Harrishao/--------/工作日志.md

# 0606

- 确定运动方案
- 确定构件尺寸

# 0607

- 完成下冲头机构建模与独立组装，凸轮配合驱动正常，往复行程 24mm 验证通过
- 完成上冲头凸轮、摆杆、滚子建模（连杆、滑块/冲头待建）
- 细化下冲头顶出/复位与粉筛推卸相位，使各凸轮工作行程压力角 ≤30°；同步更新运动方案文档与运动循环图，三处数据一致
- 导出三套凸轮廓线 CSV（供 SolidWorks 曲线导入）
- 整理工程文件：按 设计文档 / 图表 / 三维模型 / 凸轮廓线 分类归档

# 0607b

- 优化了下冲头对滚子的开槽

# 0608

- 发现凸轮和摆杆存在干涉
  - 已解决，采用z轴避让方案

# 0609

- 完成主要部件的建模
- 重新校核了一些数据

# 0610-0612

- 彻底重建整机，现在是新的设计
