Harrishao/--------/待办事项.md

# 下一步做什么？

## 三维建模与组装
- [x] 下冲头机构
- [x] 上冲头机构
- [x] 粉筛机构
- [x] 整机装配：三凸轮按相位差装上同一主轴，加传动件（带轮/齿轮/飞轮），检查干涉
- [x] 多执行机构协调运动仿真，录制动画视频

## 运动分析
- [x] 选定分析对象（上冲头机构）
- [x] 建立位移/速度/加速度解析模型，出曲线（Matlab）

## 强度与尺寸校核
- [ ] 凸轮接触强度、齿轮齿面接触与齿根弯曲
- [ ] 杆件/销/轴强度，定下目前“建模辅助”截面
- [ ] 飞轮转动惯量按盈亏功定值

## 图纸与说明书
- [ ] 2 号图纸机构运动简图（最终方案，标注尺寸与运动副）
- [ ] CAD 零件工程图
- [ ] 编写设计计算说明书

## 打包成品

- [ ] 打包成品
