Harrishao/--------/强度与尺寸校核/关键部件强度校核.docx

关键部件 初次强度与尺寸校核

15吨压片机 · 解析法（材料力学/手册公式）

# 一、校核说明与假设

本节对整机关键承力部件作初次（设计阶段）强度与尺寸校核，方法为材料力学/设计手册解析公式，不需 ADAMS/ANSYS。所用载荷与数据取自前文：压片力 Fp=150 kN、主轴扭矩 T=746.5 N·m、各传动/机构尺寸、上冲头保压位坐标。

基本假设：①静力分析，忽略摩擦与构件自重、惯性力（初次校核）；②连杆按二力杆、力沿杆轴；③材料 45 钢调质，σs≈355 MPa、σb≈600 MPa；④许用值取 [σ]=235 MPa（n=1.5）、销 [τ]=90 MPa、[σ挤]=353 MPa、轴扭转 [τT]=40 MPa、齿轮 [σH]=550 / [σF]=250 MPa、凸轮接触 [σH]=1200 MPa（表面硬化）。

# 二、上冲头保压力链 静力分析

保压时上、下冲头对压 150 kN，上冲头反力经 小连杆→上摆杆→长连杆→下摆杆→滚子→凸轮 传递。取保压位各铰点坐标，按二力杆与杠杆取矩逐级求解，得：

传力件 | 轴力/接触力 | 方向 | 说明
小连杆 (C–E) | 150.9 kN | ≈竖直 | 直接承冲头反力
长连杆 (B–D) | 279.3 kN | 沿杆轴 | 经上摆杆 R3′/R3 放大
凸轮接触力 (滚子) | ≈492 kN | 接触法向 | 经下摆杆 LB/Lr 再放大

可见二级摆杆虽缩小了凸轮、减小了摆角，但力沿传动链逐级放大，凸轮接触力远高于压片力——这是后面凸轮接触校核的关键。

# 三、各部件强度校核

部件 | 载荷 | 现尺寸 | 计算应力 | 许用 | 结论 / 建议
冲头 φ34（压缩） | 150 kN | φ34 | 165 MPa | 235 | 合格 (n=2.15)
齿轮低速级 弯曲 | Ft=8294 N | m3,b50 | σF=146 | 250 | 合格
齿轮低速级 接触 | 同上 | — | σH=388 | 550 | 合格
主轴 扭转 | 746.5 N·m | φ20 | τ=475 MPa | 40 | 不合格 → 需 ≥φ46
C 销（小连杆-冲头） | 151 kN | φ8 | τ=1501 MPa | 90 | 不合格 → 需 ≥φ33
D / B 销（长连杆） | 279 kN | φ8 | τ=2778 MPa | 90 | 不合格 → 需 ≥φ44
小连杆（拉压） | 151 kN | 30×20 | σ=252 MPa | 235 | 不合格 → A≥642 mm²
长连杆（拉压） | 279 kN | 30×20 | σ=466 MPa | 235 | 不合格 → A≥1189 mm²
长连杆（压杆稳定） | 279 kN | 30×20,L424 | Pcr=509 kN | ≥2F | 裕度不足(Pcr/F=1.8)
上冲头凸轮 接触 | 492 kN | b15 | σH=12241 MPa | 1200 | 严重超限(见四)

# 四、凸轮接触与保压力承载方式

若 150 kN 压片力全程经凸轮副承载，滚子–凸轮赫兹接触应力高达约 12 GPa，远超任何材料许用值（即使表面硬化钢约 1.2 GPa），物理上不可行。这说明：压片机的保压（压实）力不应由凸轮承担，而应由机架承担——令上冲头机构在保压位接近“死点”（连杆共线、增力趋于无穷）或设刚性止挡，使压实力闭合于机架，凸轮与连杆仅承担运动驱动及加压过程中较小的渐增力。这是单冲压片机的通行做法。

结论：现方案凸轮副不能直接承受压片力，需在保压位引入死点/机架止挡承力；否则凸轮、长连杆、各销均需按上百千牛级载荷大幅放大并配表面硬化，代价过高。

# 五、飞轮转动惯量（盈亏功法）

取运转不均匀系数 δ=0.05。压片功按“压实有效行程约 10 mm、力线性升至 150 kN”估算 Wr=½·Fp·s≈750 J，集中于加压相位（约 80°）；驱动力矩近似匀值。算得一个周期的盈亏功 ΔW≈583 J。飞轮转动惯量 J=ΔW/(δ·ω²)，装于不同轴的需求如下：

飞轮安装轴 | 需 J (kg·m²) | 说明
主轴 (25 r/min) | 1702 | 转速太低，惯量需求极大，不可行
轴 II (87.9) | 138 | 仍过大
轴 I (398.3) | 6.71 | φ300 实心盘需厚 1171 mm/596 kg，不现实
电机轴 (940) | 1.20 | 可行：φ300~400 轮缘式飞轮即可

结论：暂定的 φ280×40 飞轮（J≈0.17 kg·m²）严重不足。飞轮应装在高速轴（电机轴/轴I）以减小所需惯量；建议装电机轴，做成 φ300~400 的轮缘式（辐板+厚轮缘）飞轮以达 J≈1.2 kg·m²。ΔW 对压实功假设较敏感，待压实力-位移曲线确定后再修正。

# 六、总结与修正建议

合格项：冲头 φ34（n≈2.15）、两级齿轮（弯曲/接触均有裕度）、V 带（3 根 A 型，前已校）、粉筛机构（轻载，现截面足够）。

需修正项：① 主轴由 φ20 放大到 ≥φ46（按扭转，宜取 φ50 并校弯扭合成）；② 承力销 C 由 φ8 增至 ≥φ35、D/B 增至 ≥φ45（或改用关节轴承）；③ 小连杆截面 A≥650 mm²、长连杆 A≥1200 mm² 并校压杆稳定（宜加大惯性矩）；④ 飞轮改装电机轴、做成 φ300~400 轮缘式，J≈1.2 kg·m²。

关键设计建议：在保压位引入连杆死点或机架刚性止挡，使压片力闭合于机架而非凸轮，从根本上解决凸轮接触与连杆/销的高载问题；据此再复核一次承力件即可定终值。
