Harrishao/--------/重建方案/传动系统设计.md

# 传动系统设计（整机装配收尾用）

> 路线：电机 Y112M-6（2.2 kW，940 r/min，6极）→ A型V带 → 轴 I → 直齿轮两级减速 → 主轴。
> 总传动比需求 i = 940/25 = 37.6；实际 2.36 × 4.529 × 3.529 = **37.73**，主轴 **24.92 r/min**（偏差 −0.3%，可接受）。
> 配套：参考图_传动系统.png · 传动系统.py（参数改后重跑即可）

## 1. V带传动（A型 ×3）

| 项 | 值 |
|---|---|
| 小带轮 dd1 / 大带轮 dd2 | 100 / 236（标准系列） |
| 传动比 i1 | 2.36 |
| 带速 v | 4.92 m/s（5~25 合格） |
| 基准长度 | L0=1339 → 取 **Ld=1400（A1400）**，实际中心距 a ≈ **430** |
| 小轮包角 α1 | 161.9° ≥ 120° ✓ |
| 根数 | KA=1.2，Pca=2.64 kW → z=2.73 → **3 根** |

## 2. 齿轮（直齿，45钢调质，强度校核留待校核阶段）

| 级 | m | z | i | 分度圆 d | 中心距 a | 齿宽建议 |
|---|---|---|---|---|---|---|
| 高速级 z1/z2 | 2 | 17 / 77 | 4.529 | 34 / 154 | **94** | b2=40，b1=45 |
| 低速级 z3/z4 | 3 | 17 / 60 | 3.529 | 51 / 180 | **115.5** | b4=45，b3=50 |

转速 / 转矩（η带0.96、η齿0.97、η轴承0.99）：轴 I 398.3 r/min、50.6 N·m；轴 II 87.9 r/min、220.3 N·m；主轴 24.92 r/min、**746.5 N·m**。

## 3. 布置（关键：与机构错开）

三轴平行于 Z、竖排在主轴正下方；齿轮组放在**凸轮组对侧（Z<0）**，与全部杆系错开：

| 轴 | XY 位置 | 件与轴向站位（中面 Z） |
|---|---|---|
| 主轴 (0,0) | 已有 | 三凸轮 Z=0 / 67.5 / 132.5（不动）；**z4 加装在 Z=−60**（宽45） |
| 轴 II | **(0, −115.5)** | z3 Z=−60（宽50）；z2 Z=−110（宽40） |
| 轴 I | **(0, −209.5)** | z1 Z=−110（宽45）；大带轮 Z=−165；飞轮 Z=−195（暂定 φ280×40，惯量待盈亏功计算后修正） |
| 电机轴 | **(430, −209.5)**（水平置右） | 小带轮与大带轮同站位 Z=−165 |

干涉要点：z4（r=90）在 Z −82.5~−37.5，与机构杆系层（Z≈0±25）轴向错开——建模时各摆杆/连杆本体厚度保持 |Z|≤25；z4 顶缘 Y=+90，远低于台面 186；轴 II 轴线距主轴 115.5，大于一切凸轮最大半径（82）。主轴需向 Z<0 延长约 100（或利用现有 330 长度的富余段）。

## 4. 建模清单

带轮×2（A型轮槽×3，dd 100/236）、齿轮×4（按上表）、轴 I / 轴 II（φ按转矩初定 25 / 35，待强度校核）、飞轮（暂定件）、电机（可用简化外形 Y112M：中心高112）、轴承座×4。装好后转主轴一整圈做全程干涉检查，然后 待办事项.md 的"整机装配"即可打勾，进入运动仿真。
