Harrishao/--------/归档_旧版/_说明.md

# 归档_旧版 说明

本文件夹存放**已被重建方案取代、失去参考意义**的旧文件，仅作历史留存，勿再引用。
现行设计以 `重建方案/`（重建数据_上冲头与粉筛.md、传动系统设计.md、各 vN 廓线）和最终装配体
`三维模型/整机装配-上冲头v2-粉筛v4.SLDASM` 为准。

## 归档内容及取代关系

| 旧文件 | 被取代为 |
|---|---|
| 上冲头凸轮.csv / _SW.txt | 重建方案/上冲头凸轮v2_SW.txt（基圆 117→54） |
| 粉筛凸轮.csv / _SW.txt | 重建方案/粉筛凸轮v4_SW.txt（基圆 113.5→81） |
| 三凸轮廓线.png、凸轮压力角.png | 重建方案/参考图_凸轮工作图.png、参考图_运动与压力角.png |
| 布局_上冲头.png、布局_粉筛.png | 重建方案/参考图_上冲头机构.png、参考图_粉筛机构_v4.png、参考图_整机布局.png |
| 上冲头摆杆叉口参考.png、曲拐摆杆避让示意.png、上冲头装配前视参考.png | 上冲头已改二级摆杆增力方案，旧单摆杆图作废 |
| 整机装配参数填写表.md | 重建方案/重建数据_上冲头与粉筛.md（旧表 §1/§3/§4 已作废） |

注：布局_下冲头.png、运动循环图*.png 仍保留在 图表/（下冲头未变；循环图待按重建把粉筛左退 90~120→90~135 更新）。
