Harrishao/--------/重建方案/参考图_传动系统.png

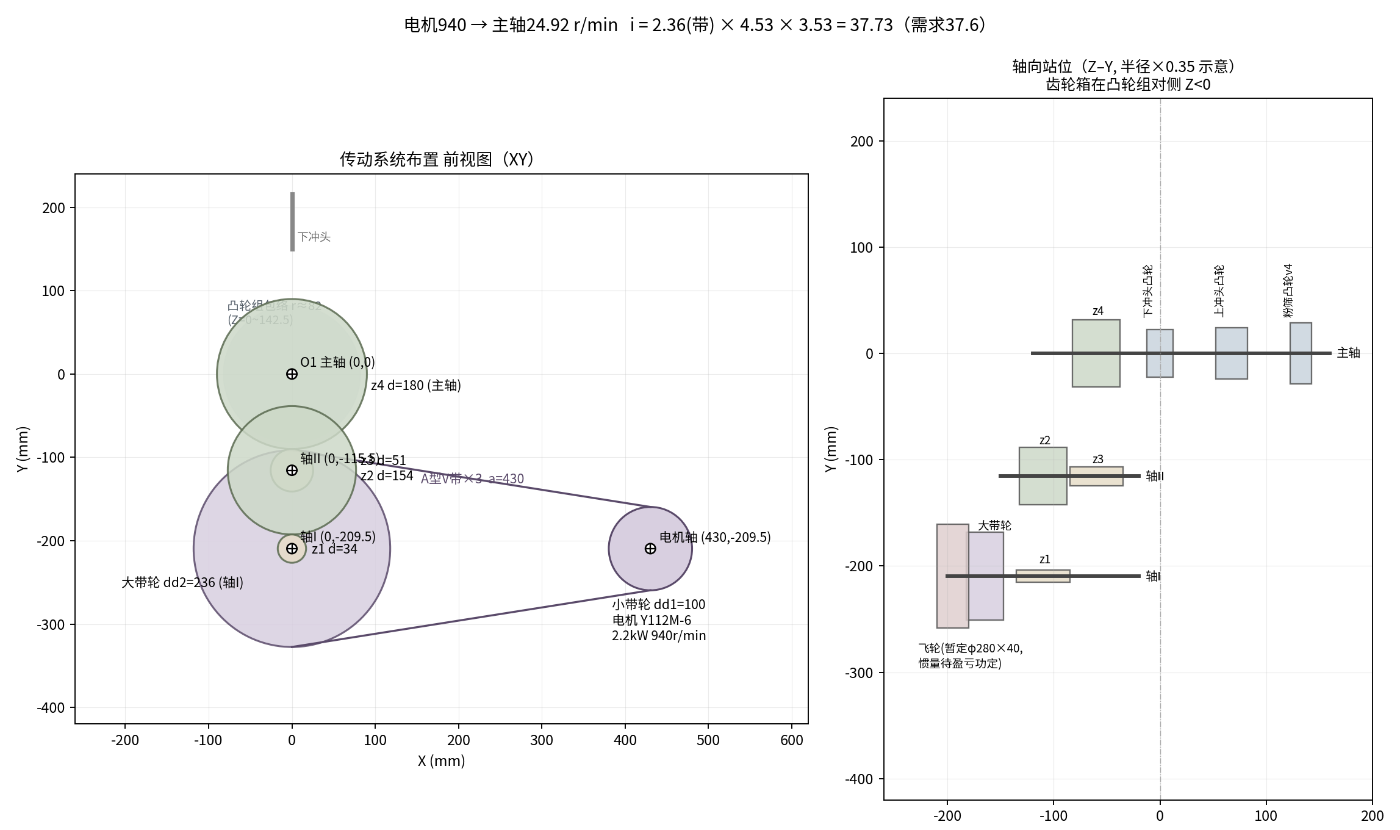
重建方案/参考图_传动系统.png
