Harrishao/--------/重建方案/带轮截面示意.png

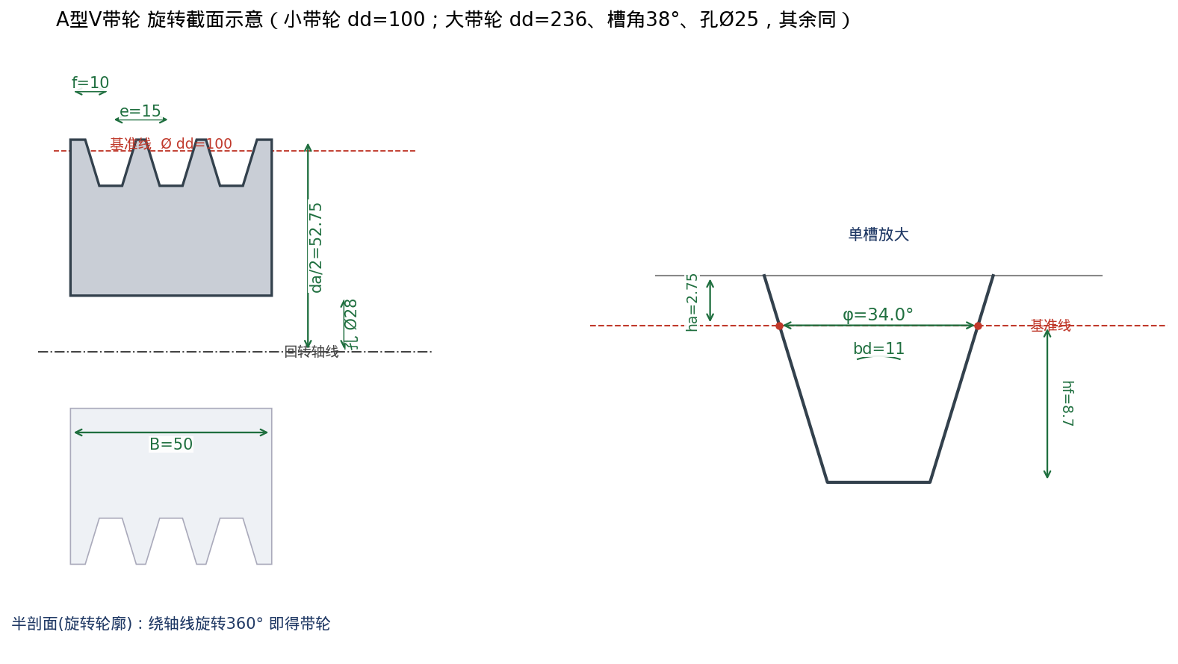
重建方案/带轮截面示意.png
