Harrishao/--------/三维模型/上冲头下摆杆v2.SLDPRT

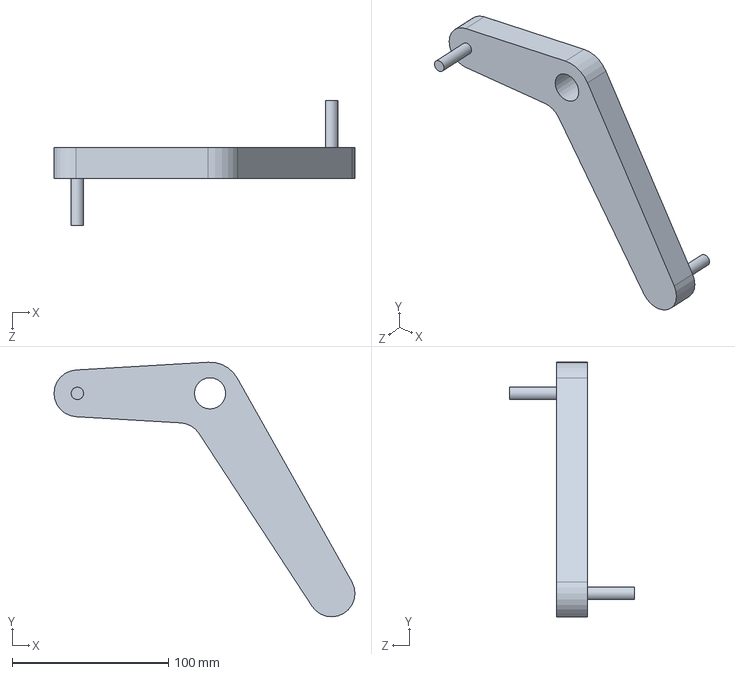
[picture p5: CAD file, 2026-06-14]
三维模型/上冲头下摆杆v2.SLDPRT
192.9 x 163.2 x 80.0 mm
