Harrishao/--------/三维模型/齿轮z3.SLDPRT

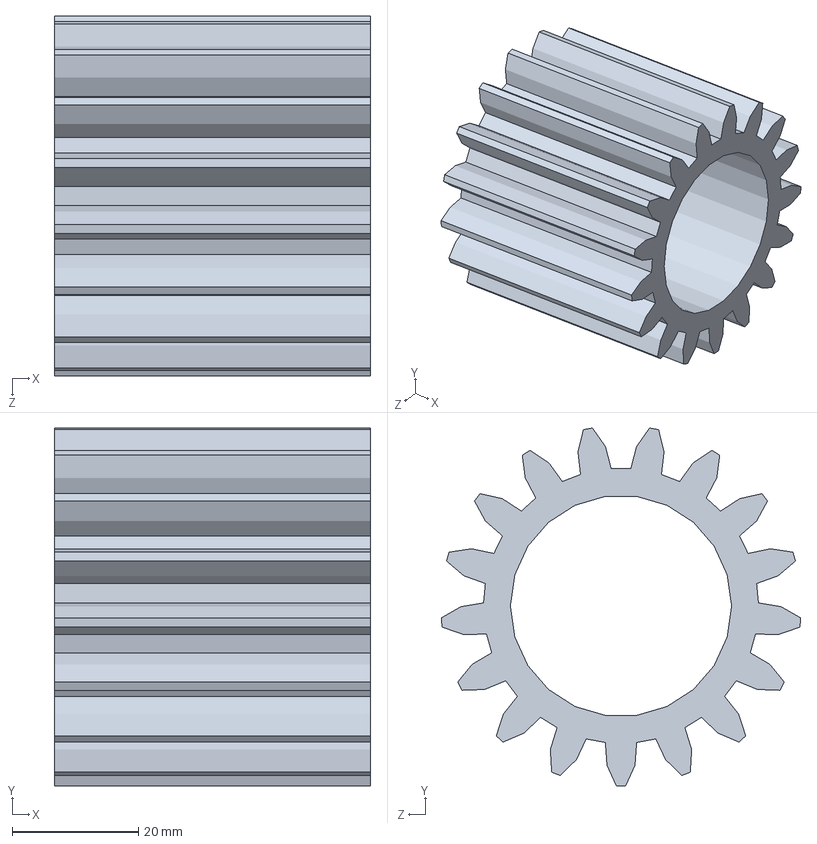
[picture p6: CAD file, 2026-06-13]
三维模型/齿轮z3.SLDPRT
50.0 x 56.6 x 56.9 mm
