Harrishao/--------/三维模型/小带轮.SLDPRT

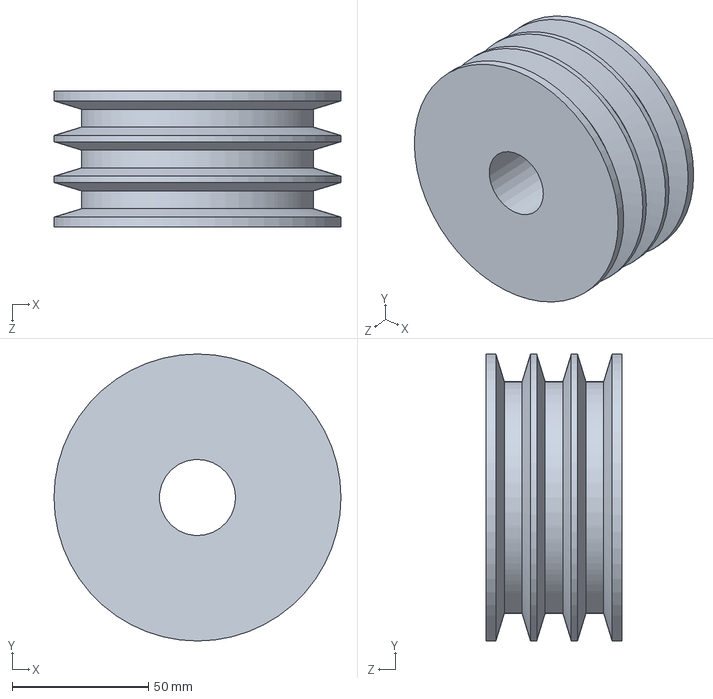
[picture p7: CAD file, 2026-06-13]
三维模型/小带轮.SLDPRT
105.5 x 105.5 x 50.0 mm
