Harrishao/--------/三维模型/齿轮z4.SLDPRT

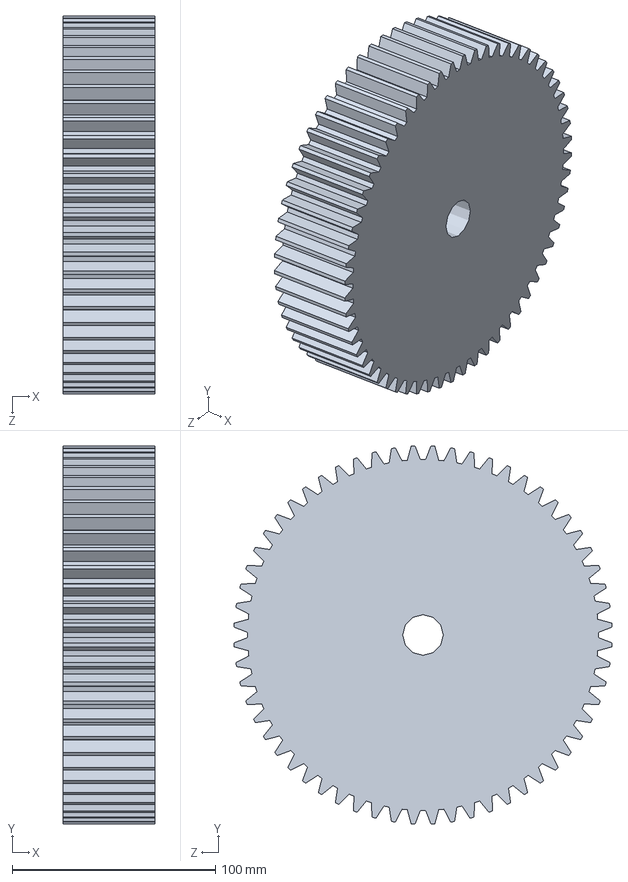
[picture p8: CAD file, 2026-06-13]
三维模型/齿轮z4.SLDPRT
45.0 x 185.8 x 185.8 mm
