Harrishao/--------/三维模型/d25传动轴.SLDPRT

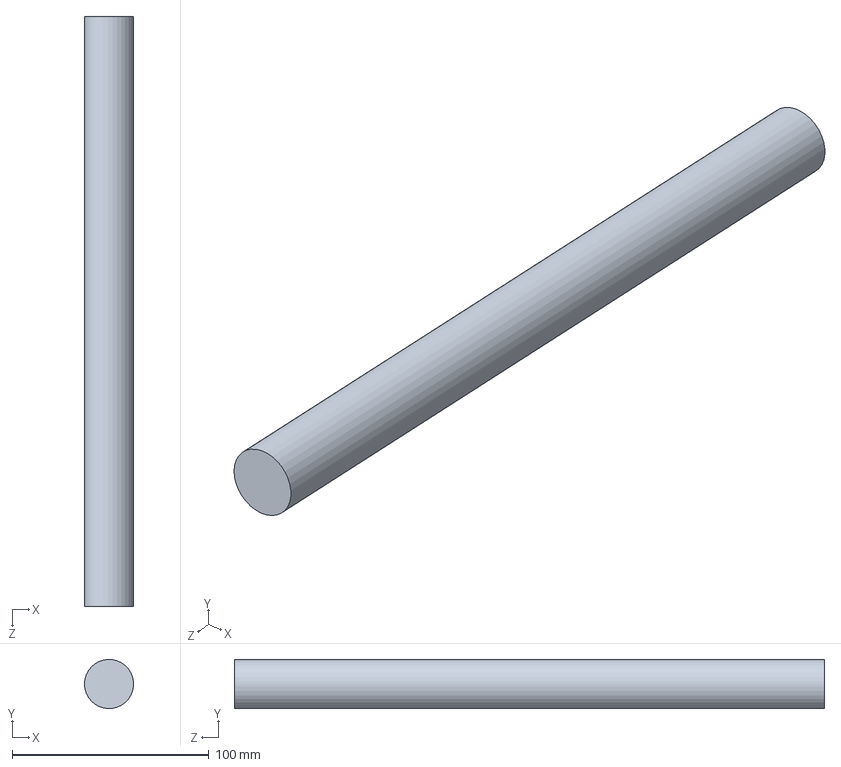
[picture p9: CAD file, 2026-06-13]
三维模型/d25传动轴.SLDPRT
25.0 x 25.0 x 300.0 mm
