Harrishao/--------/三维模型/齿轮z2.SLDPRT

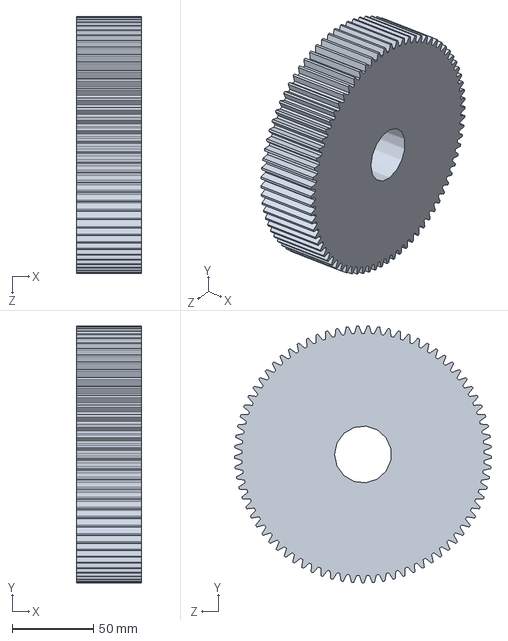
[picture p10: CAD file, 2026-06-13]
三维模型/齿轮z2.SLDPRT
40.0 x 158.0 x 158.0 mm
