Harrishao/--------/三维模型/d35传动轴.SLDPRT

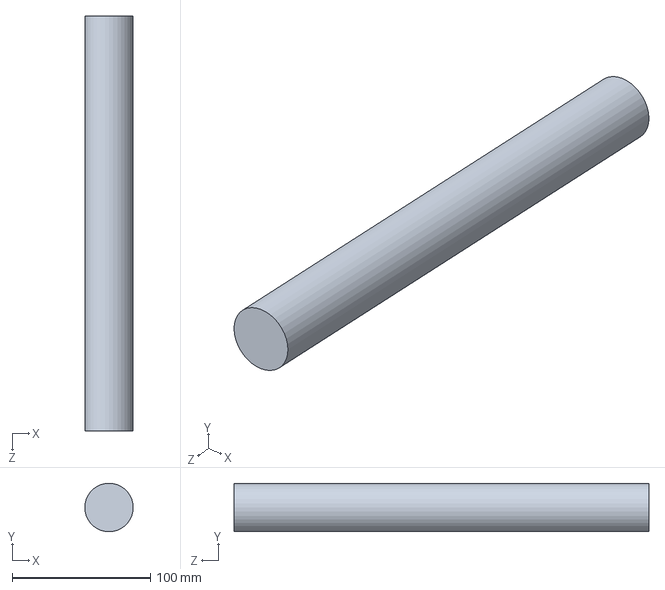
[picture p11: CAD file, 2026-06-13]
三维模型/d35传动轴.SLDPRT
35.0 x 35.0 x 300.0 mm
