Harrishao/--------/三维模型/齿轮z1.SLDPRT

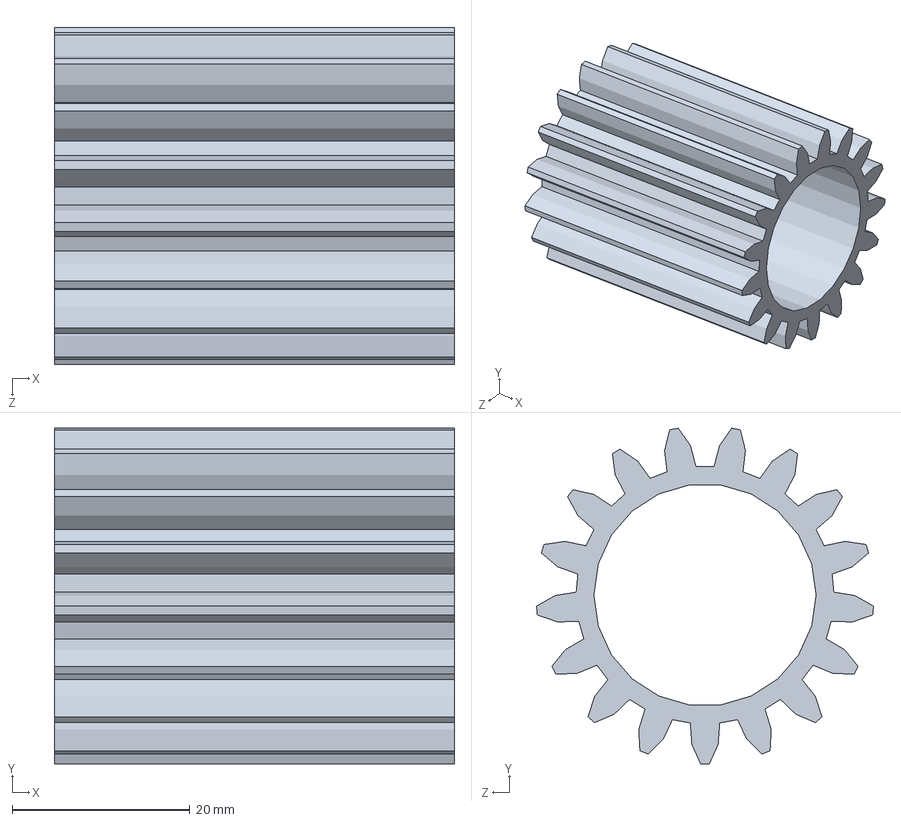
[picture p12: CAD file, 2026-06-13]
三维模型/齿轮z1.SLDPRT
45.0 x 37.8 x 37.9 mm
