Harrishao/--------/三维模型/飞轮.SLDPRT

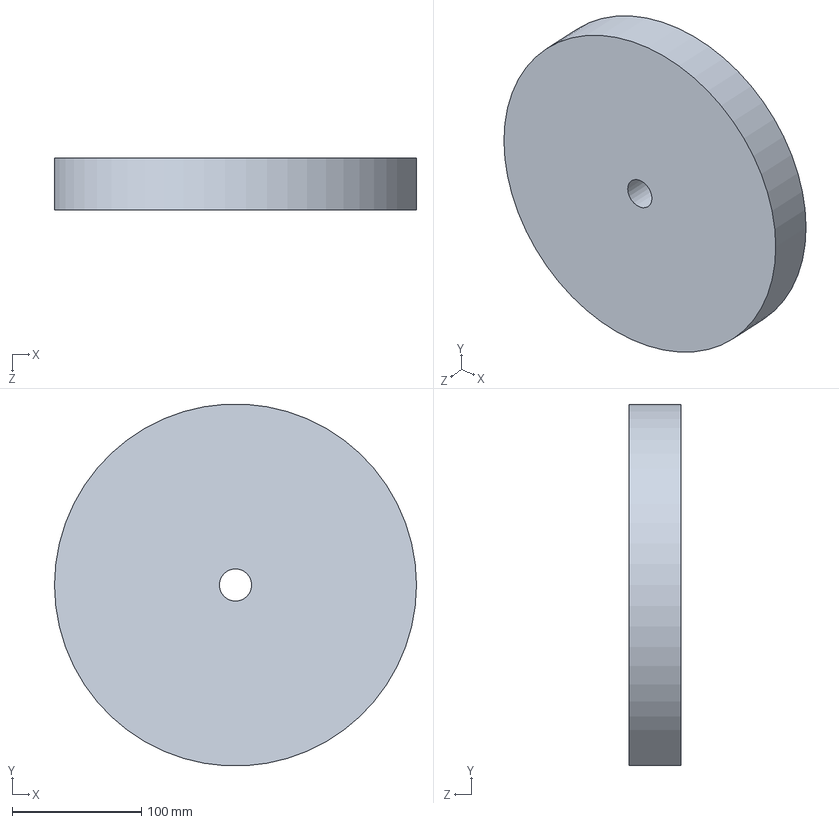
[picture p13: CAD file, 2026-06-13]
三维模型/飞轮.SLDPRT
280.0 x 279.5 x 40.0 mm
