Harrishao/--------/三维模型/大带轮.SLDPRT

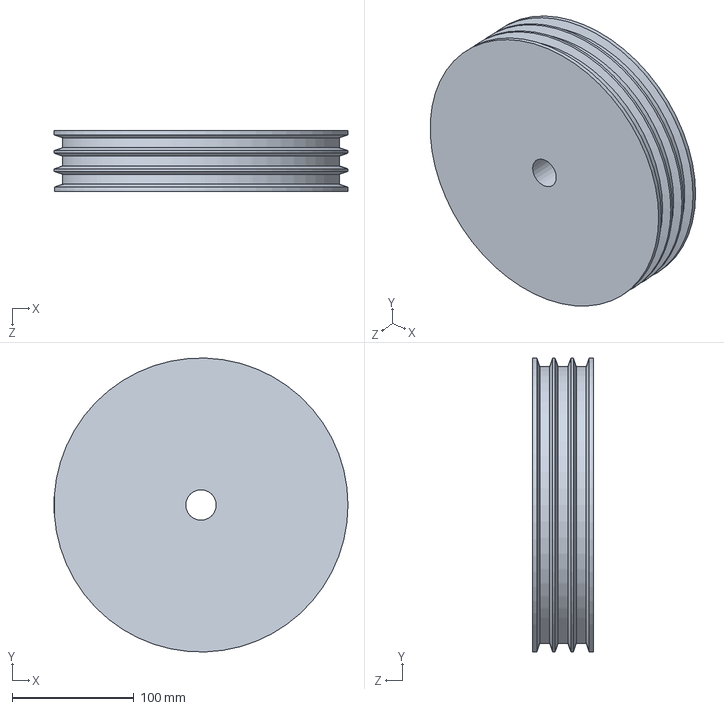
[picture p14: CAD file, 2026-06-13]
三维模型/大带轮.SLDPRT
241.5 x 241.4 x 50.0 mm
