Harrishao/--------/三维模型/IE3 Electric Motor 112l 6p B3/5561120109_17.SLDPRT

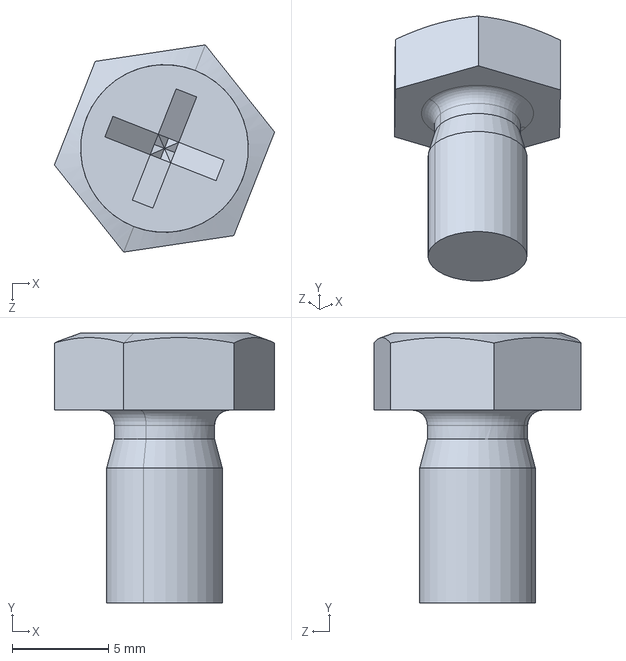
[picture p15: CAD file, 2026-06-13]
三维模型/IE3 Electric Motor 112l 6p B3/5561120109_17.SLDPRT
11.4 x 14.0 x 10.7 mm
