Harrishao/--------/三维模型/IE3 Electric Motor 112l 6p B3/5561120109_10.SLDPRT

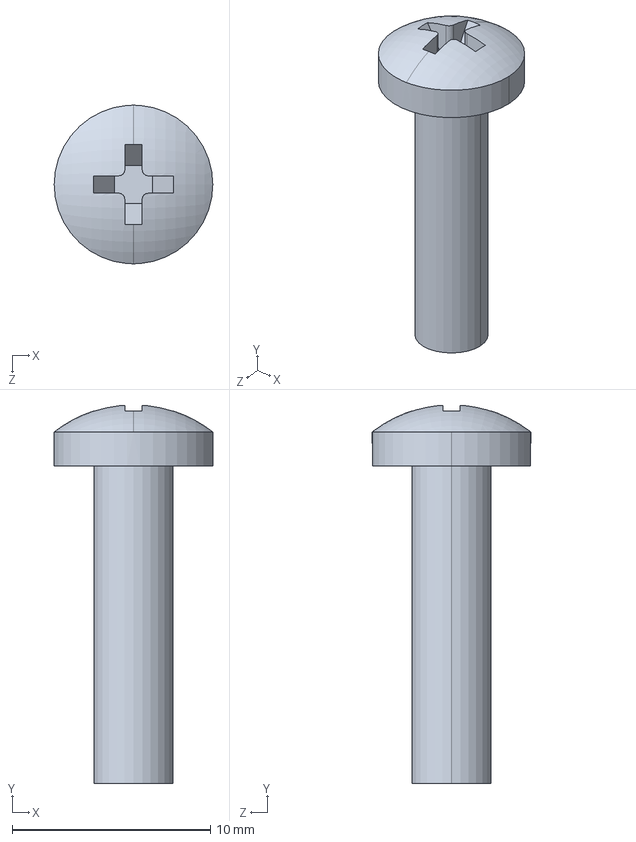
[picture p16: CAD file, 2026-06-13]
三维模型/IE3 Electric Motor 112l 6p B3/5561120109_10.SLDPRT
8.00 x 19.1 x 8.00 mm
