Harrishao/--------/三维模型/IE3 Electric Motor 112l 6p B3/5561120109_38.SLDPRT

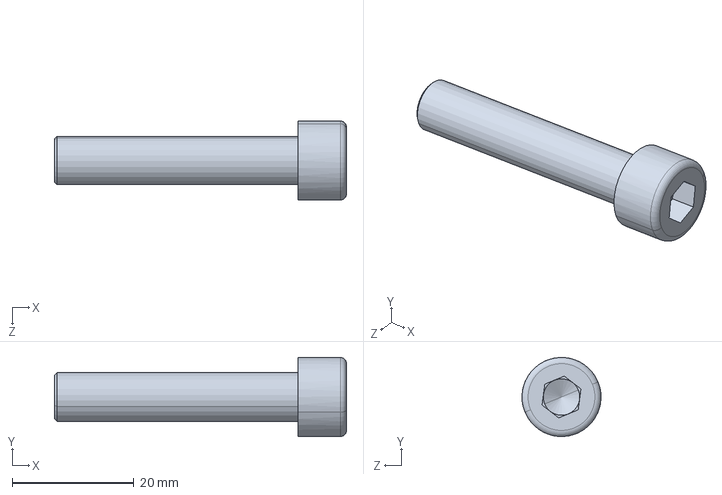
[picture p17: CAD file, 2026-06-13]
三维模型/IE3 Electric Motor 112l 6p B3/5561120109_38.SLDPRT
48.0 x 13.0 x 13.0 mm
