Harrishao/--------/三维模型/IE3 Electric Motor 112l 6p B3/5561120109_42.SLDPRT

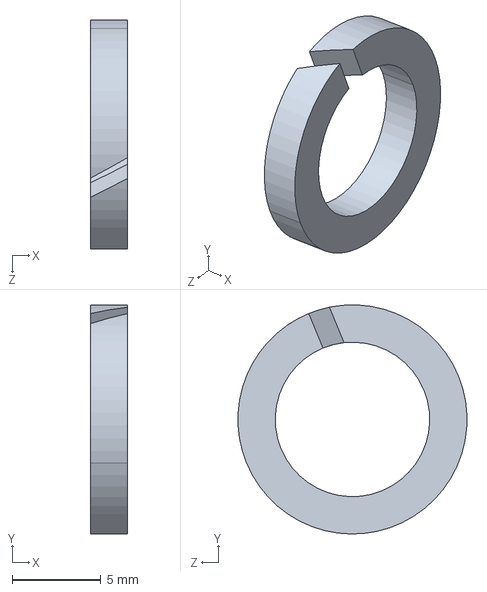
[picture p18: CAD file, 2026-06-13]
三维模型/IE3 Electric Motor 112l 6p B3/5561120109_42.SLDPRT
2.10 x 12.9 x 12.9 mm
