Harrishao/--------/三维模型/上冲头-运动分析.SLDASM

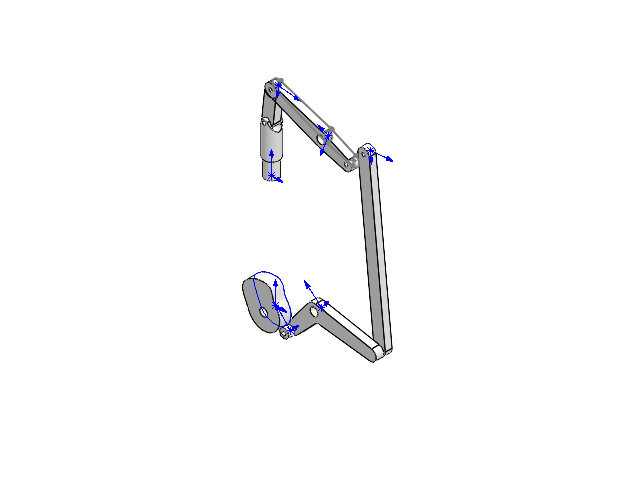
[picture p19: CAD file, 2026-06-14]
三维模型/上冲头-运动分析.SLDASM
上冲头凸轮v2
上冲头下摆杆v2
上冲头滚子
上冲头长连杆v2
上冲头上摆杆v2
上冲头短连杆v2
上冲头v2
