Harrishao/--------/三维模型/整机装配-上冲头v2-粉筛v4.SLDASM

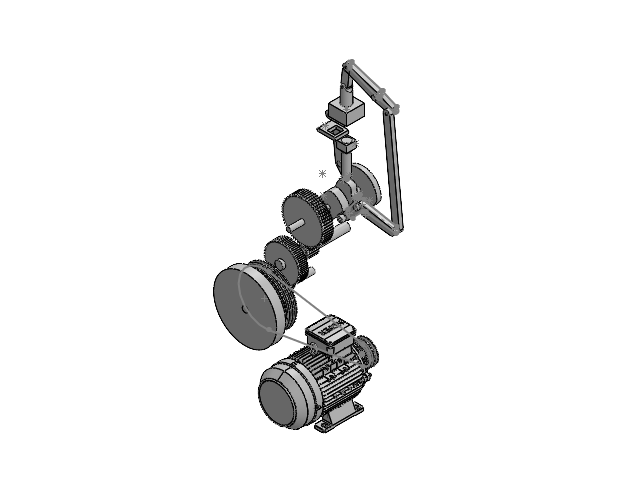
[picture p20: CAD file, 2026-06-13]
三维模型/整机装配-上冲头v2-粉筛v4.SLDASM
主轴
下冲头凸轮
下冲头滚子
d8销
下冲头
上冲头凸轮v2
d20销 x 3
上冲头下摆杆v2
上冲头滚子
上冲头上摆杆v2
上冲头长连杆v2
d8销l40 x 2
上冲头短连杆v2
上冲头v2
d8销l22
导向套
型腔
粉筛滚子
d8销l45
d8销l80
粉筛凸轮v4
粉筛摆杆v4
粉筛连杆v4
粉筛托架v4
d35传动轴
d25传动轴
spur gear_gb x 4
大带轮
飞轮
小带轮
