Harrishao/--------/三维模型/IE3 Electric Motor 112l 6p B3/5561120109.SLDASM

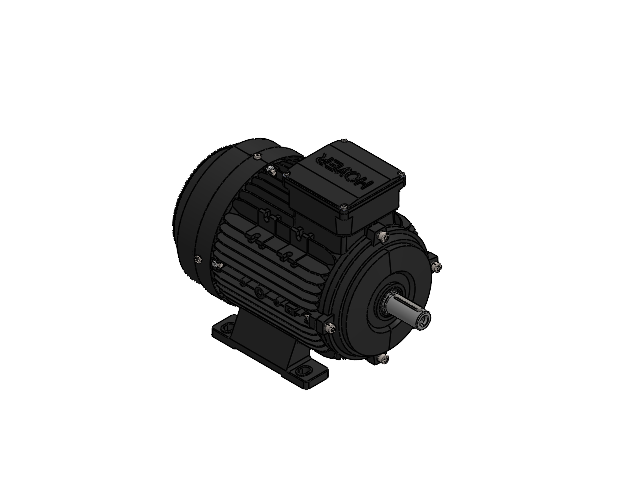
[picture p21: CAD file, 2026-06-13]
三维模型/IE3 Electric Motor 112l 6p B3/5561120109.SLDASM
