Harrishao/--------/(list of files, cad)

Other CAD files:
三维模型/IE3 Electric Motor 112l 6p B3/5561120109_45.SLDPRT
三维模型/IE3 Electric Motor 112l 6p B3/5561120109_01.SLDPRT
三维模型/IE3 Electric Motor 112l 6p B3/5561120109_02.SLDPRT
三维模型/IE3 Electric Motor 112l 6p B3/5561120109_03.SLDPRT
三维模型/IE3 Electric Motor 112l 6p B3/5561120109_04.SLDPRT
三维模型/IE3 Electric Motor 112l 6p B3/5561120109_05.SLDPRT
三维模型/IE3 Electric Motor 112l 6p B3/5561120109_06.SLDPRT
三维模型/IE3 Electric Motor 112l 6p B3/5561120109_07.SLDPRT
三维模型/IE3 Electric Motor 112l 6p B3/5561120109_08.SLDPRT
三维模型/IE3 Electric Motor 112l 6p B3/5561120109_09.SLDPRT
三维模型/IE3 Electric Motor 112l 6p B3/5561120109_11.SLDPRT
三维模型/IE3 Electric Motor 112l 6p B3/5561120109_12.SLDPRT
三维模型/IE3 Electric Motor 112l 6p B3/5561120109_13.SLDPRT
三维模型/IE3 Electric Motor 112l 6p B3/5561120109_14.SLDPRT
三维模型/IE3 Electric Motor 112l 6p B3/5561120109_15.SLDPRT
三维模型/IE3 Electric Motor 112l 6p B3/5561120109_16.SLDPRT
三维模型/IE3 Electric Motor 112l 6p B3/5561120109_18.SLDPRT
三维模型/IE3 Electric Motor 112l 6p B3/5561120109_19.SLDPRT
三维模型/IE3 Electric Motor 112l 6p B3/5561120109_20.SLDPRT
三维模型/IE3 Electric Motor 112l 6p B3/5561120109_21.SLDPRT
三维模型/IE3 Electric Motor 112l 6p B3/5561120109_22.SLDPRT
三维模型/IE3 Electric Motor 112l 6p B3/5561120109_23.SLDPRT
三维模型/IE3 Electric Motor 112l 6p B3/5561120109_24.SLDPRT
三维模型/IE3 Electric Motor 112l 6p B3/5561120109_25.SLDPRT
三维模型/IE3 Electric Motor 112l 6p B3/5561120109_26.SLDPRT
三维模型/IE3 Electric Motor 112l 6p B3/5561120109_27.SLDPRT
三维模型/IE3 Electric Motor 112l 6p B3/5561120109_28.SLDPRT
三维模型/IE3 Electric Motor 112l 6p B3/5561120109_29.SLDPRT
三维模型/IE3 Electric Motor 112l 6p B3/5561120109_30.SLDPRT
三维模型/IE3 Electric Motor 112l 6p B3/5561120109_31.SLDPRT
三维模型/IE3 Electric Motor 112l 6p B3/5561120109_32.SLDPRT
三维模型/IE3 Electric Motor 112l 6p B3/5561120109_33.SLDPRT
三维模型/IE3 Electric Motor 112l 6p B3/5561120109_34.SLDPRT
三维模型/IE3 Electric Motor 112l 6p B3/5561120109_35.SLDPRT
三维模型/IE3 Electric Motor 112l 6p B3/5561120109_36.SLDPRT
三维模型/IE3 Electric Motor 112l 6p B3/5561120109_37.SLDPRT
三维模型/IE3 Electric Motor 112l 6p B3/5561120109_39.SLDPRT
三维模型/IE3 Electric Motor 112l 6p B3/5561120109_40.SLDPRT
三维模型/IE3 Electric Motor 112l 6p B3/5561120109_41.SLDPRT
三维模型/IE3 Electric Motor 112l 6p B3/5561120109_43.SLDPRT
三维模型/IE3 Electric Motor 112l 6p B3/5561120109_44.SLDPRT
三维模型/IE3 Electric Motor 112l 6p B3/5561120109_46.SLDPRT
三维模型/IE3 Electric Motor 112l 6p B3/5561120109_47.SLDPRT
三维模型/IE3 Electric Motor 112l 6p B3/5561120109_48.SLDPRT
三维模型/IE3 Electric Motor 112l 6p B3/5561120109_49.SLDPRT
三维模型/IE3 Electric Motor 112l 6p B3/5561120109_50.SLDPRT
三维模型/IE3 Electric Motor 112l 6p B3/5561120109_51.SLDPRT
三维模型/IE3 Electric Motor 112l 6p B3/5561120109_52.SLDPRT
三维模型/IE3 Electric Motor 112l 6p B3/5561120109_53.SLDPRT
三维模型/IE3 Electric Motor 112l 6p B3/5561120109_54.SLDPRT
三维模型/IE3 Electric Motor 112l 6p B3/5561120109_55.SLDPRT
