Harrishao/--------/(commit log)

2026-06-06 はわわわ…
2026-06-14 0614强度校核
